candykingdom/hvac-v2/hardware/ref/hvac-v2_back.png

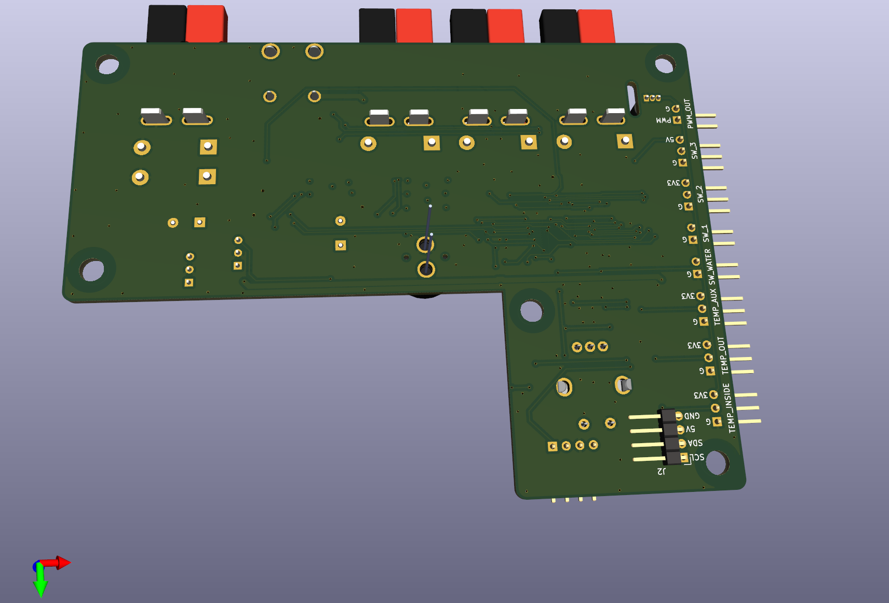
hardware/ref/hvac-v2_back.png
