candykingdom/hvac-v2/hardware/ref/hvac-v2_front.png

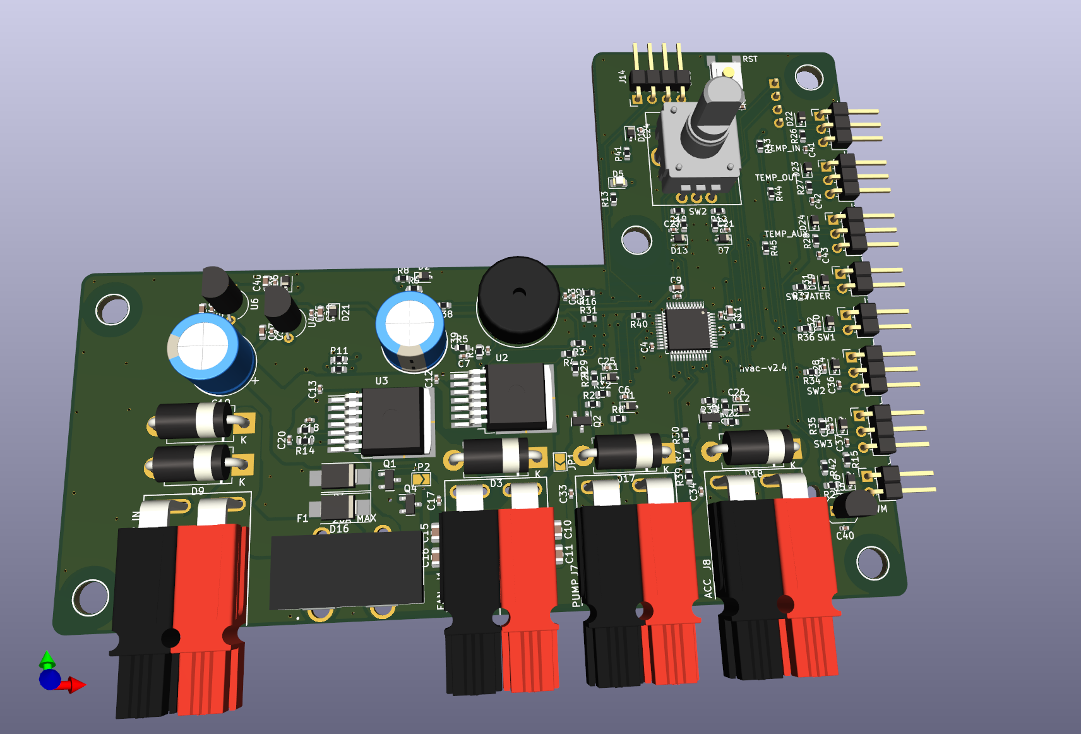
hardware/ref/hvac-v2_front.png
