candykingdom/hvac-v2/hardware/hvac-v2.kicad_pcb

## KiCad design hardware/hvac-v2.kicad_pcb (2022-07-19)

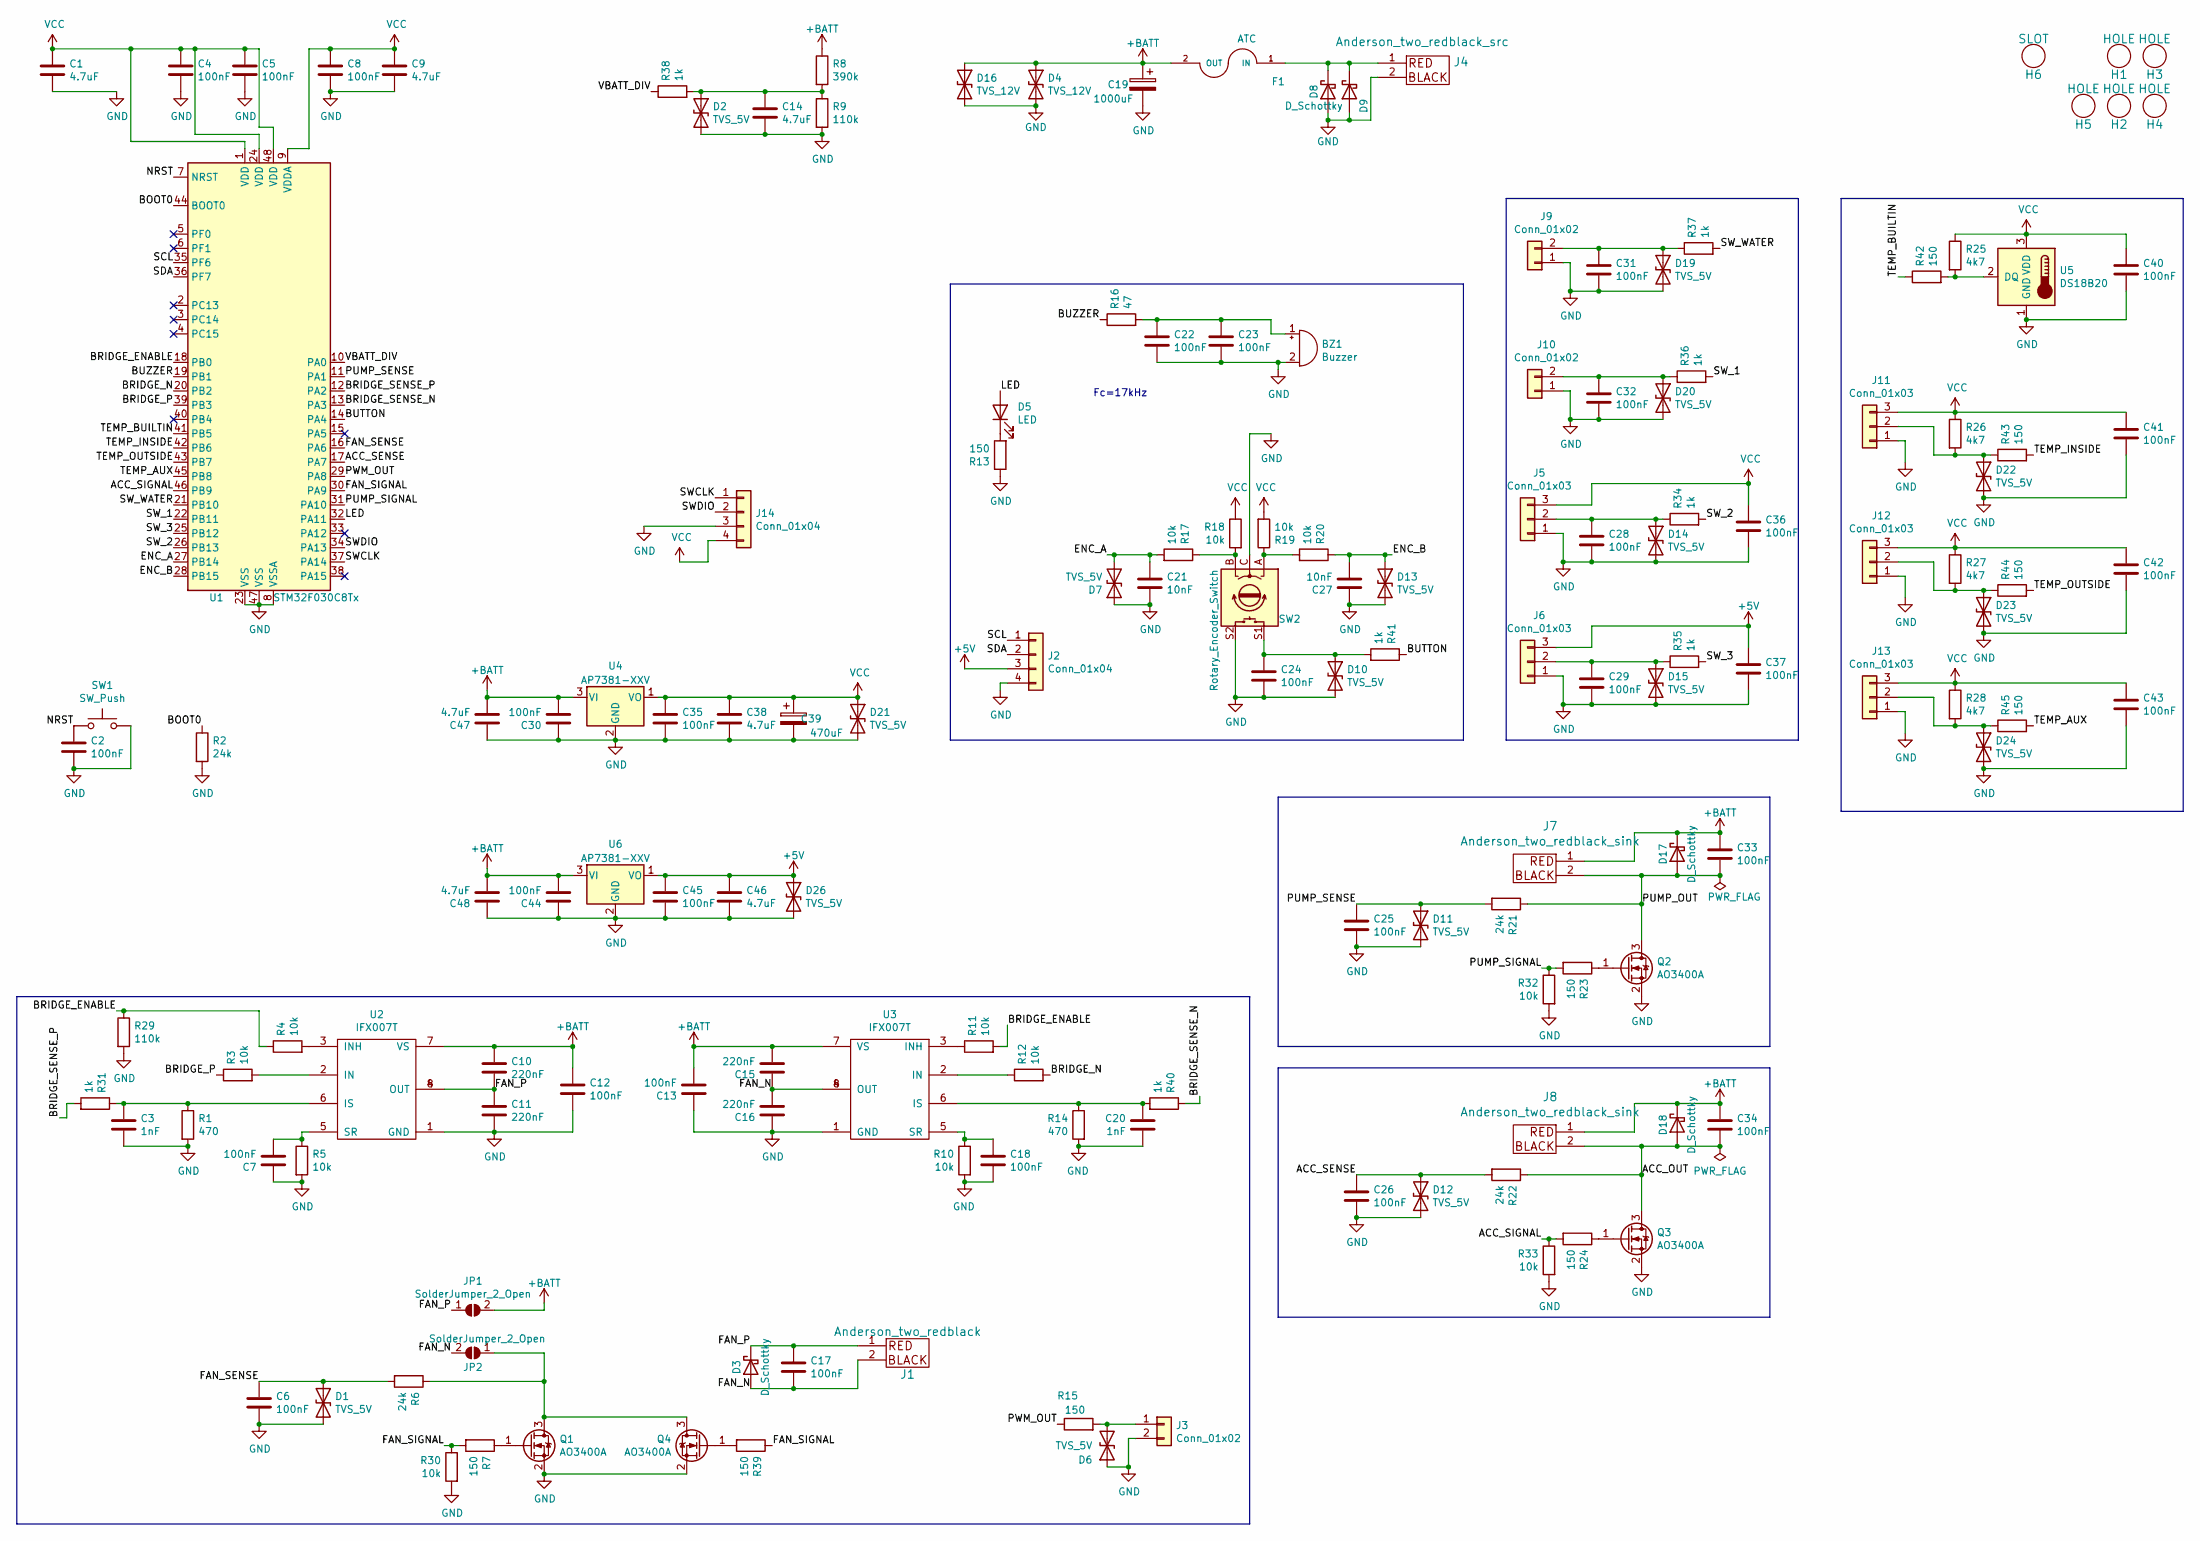
[picture p4: schematic hvac-v2.kicad_sch]

Parts:
BZ1: Buzzer; MURATA_PKM13EPYH4000-A0; MPN PKM13EPYH4000-A0
C1, C9, C14, C38, C46, C47, C48: 4.7uF; C_0603_1608Metric; LCSC C19666
C2, C4, C5, C6, C7, C8, C12, C13, C17, C18, C22, C23, C24, C25, C26, C28, C29, C30, C31, C32, C33, C34, C35, C36, C37, C40, C41, C42, C43, C44, C45: 100nF; C_0402_1005Metric; LCSC C307331
C3, C20: 1nF; C_0402_1005Metric; LCSC C1523
C10, C11, C15, C16: 220nF; C_0805_2012Metric; LCSC C5378
C19: 1000uF; CP_Radial_D10.0mm_P5.00mm; MPN 25PK1000MEFC10X16
C21, C27: 10nF; C_0402_1005Metric; LCSC C15195
C39: 470uF; CP_Radial_D10.0mm_P5.00mm; MPN 25PK1000MEFC10X16
D1, D2, D6, D7, D10, D11, D12, D13, D14, D15, D19, D20, D21, D22, D23, D24, D26: TVS_5V; D_SOD-323; LCSC C182013
D3, D8, D9, D17, D18: D_Schottky; D_DO-201AD_P12.70mm_Horizontal; MPN SB10150TA
D4, D16: TVS_12V; D_SMB_Handsoldering; MPN SMBJ16CA
D5: LED; LED_0805_2012Metric; LCSC C84256
F1: ATC; FUSE_3550-2; MPN 3550-2
H1, H2, H3, H4, H5: HOLE; HOLE_M4
H6: SLOT; SLOT_W2mm_H8mm
J1: Anderson_two_redblack; Anderson_1336G1_right_angle_bottom_two
J2, J14: Conn_01x04; PinHeader_1x04_P2.54mm_Horizontal
J3, J9, J10: Conn_01x02; PinHeader_1x02_P2.54mm_Horizontal
J4: Anderson_two_redblack_src; Anderson_1336G1_right_angle_bottom_two
J5, J6, J11, J12, J13: Conn_01x03; PinHeader_1x03_P2.54mm_Horizontal
J7, J8: Anderson_two_redblack_sink; Anderson_1336G1_right_angle_bottom_two
JP1, JP2: SolderJumper_2_Open; SolderJumper-2_P1.3mm_Open_TrianglePad1.0x1.5mm
Q1, Q2, Q3, Q4: AO3400A; SOT-23; LCSC C20917
R1, R14: 470; R_0603_1608Metric; LCSC C23179
R2, R6, R21, R22: 24k; R_0603_1608Metric; LCSC C23352
R3, R4, R5, R10, R11, R12, R17, R18, R19, R20, R30, R32, R33: 10k; R_0603_1608Metric; LCSC C25804
R7, R13, R15, R23, R24, R39, R42, R43, R44, R45: 150; R_0603_1608Metric; LCSC C22808
R8: 390k; R_0603_1608Metric; LCSC C23150
R9, R29: 110k; R_0603_1608Metric; LCSC C25805
R16: 47; R_0603_1608Metric; LCSC C23182
R25, R26, R27, R28: 4k7; R_0603_1608Metric; LCSC C23162
R31, R40, R41: 1k; R_0603_1608Metric; LCSC C11702
R34, R35, R36, R37, R38: 1k; R_0603_1608Metric; LCSC C22808
SW1: SW_Push; SW_TACTILE_5.1MM_TS-1187A-C-D-B; LCSC C318884
SW2: Rotary_Encoder_Switch; BOURNS_PEC12R-4xxxF-Sxxxx; MPN PEC12R-4230F-S0024
U1: STM32F030C8Tx; LQFP-48_7x7mm_P0.5mm; LCSC C23922
U2, U3: IFX007T; TO-263-7_TabPin8; MPN IFX007T
U4: AP7381-XXV; TO-92L_Inline_Wide; MPN AP7381-33V
U5: DS18B20; TO-92_Inline; MPN DS18B20
U6: AP7381-XXV; TO-92L_Inline_Wide; MPN AP7381-50V

Connections:
+5V: C37.1, C45.1, C46.1, D26.1 (A1), J2.3, J6.3, U6.1 (VO)
+BATT: C10.1, C12.1, C13.2, C15.2, C19.1, C30.2, C33.1, C34.1, C44.2, C47.2, C48.2, D4.1 (A1), D16.1 (A1), D17.1 (K), D18.1 (K), F1.2 (OUT), J7.1, J8.1, JP1.2 (B), R8.1, U2.7 (VS), U3.7 (VS), U4.3 (VI), U6.3 (VI)
/ACC_OUT: C34.2, D18.2 (A), J8.2, Q3.3 (D), R22.1
/ACC_SENSE: C26.1, D12.1 (A1), R22.2, U1.17 (PA7)
/ACC_SIGNAL: R24.2, R33.1, U1.46 (PB9)
/BOOT0: R2.1, U1.44 (BOOT0)
/BRIDGE_ENABLE: R4.1, R11.2, R29.1, U1.18 (PB0)
/BRIDGE_N: R12.2, U1.20 (PB2)
/BRIDGE_P: R3.1, U1.39 (PB3)
/BRIDGE_SENSE_N: R40.1, U1.13 (PA3)
/BRIDGE_SENSE_P: R31.2, U1.12 (PA2)
/BUTTON: R41.1, U1.14 (PA4)
/BUZZER: R16.1, U1.19 (PB1)
/ENC_A: C21.1, D7.2 (A2), R17.2, U1.27 (PB14)
/ENC_B: C27.2, D13.1 (A1), R20.1, U1.28 (PB15)
/FAN_N: C15.1, C16.2, C17.2, D3.2 (A), J1.2, JP2.2 (B), U3.4 (OUT), U3.8 (OUT)
/FAN_P: C10.2, C11.1, C17.1, D3.1 (K), J1.1, JP1.1 (A), U2.4 (OUT), U2.8 (OUT)
/FAN_SENSE: C6.1, D1.1 (A1), R6.2, U1.16 (PA6)
/FAN_SIGNAL: R7.2, R30.1, R39.1, U1.30 (PA9)
/LED: D5.2 (A), U1.32 (PA11)
/NRST: C2.1, SW1.1, U1.7 (NRST)
/PUMP_OUT: C33.2, D17.2 (A), J7.2, Q2.3 (D), R21.1
/PUMP_SENSE: C25.1, D11.1 (A1), R21.2, U1.11 (PA1)
/PUMP_SIGNAL: R23.2, R32.1, U1.31 (PA10)
/PWM_OUT: R15.1, U1.29 (PA8)
/SCL: J2.1, U1.35 (PF6)
/SDA: J2.2, U1.36 (PF7)
/SWCLK: J14.1, U1.37 (PA14)
/SWDIO: J14.2, U1.34 (PA13)
/SW_1: R36.2, U1.22 (PB11)
/SW_2: R34.2, U1.26 (PB13)
/SW_3: R35.2, U1.25 (PB12)
/SW_WATER: R37.2, U1.21 (PB10)
/TEMP_AUX: R45.2, U1.45 (PB8)
/TEMP_BUILTIN: R42.1, U1.41 (PB5)
/TEMP_INSIDE: R43.2, U1.42 (PB6)
/TEMP_OUTSIDE: R44.2, U1.43 (PB7)
/VBATT_DIV: R38.1, U1.10 (PA0)
GND: BZ1.2 (+), C1.2, C2.2, C3.2, C4.2, C5.2, C6.2, C7.1, C8.2, C9.2, C11.2, C12.2, C13.1, C14.2, C16.1, C18.2, C19.2, C20.2, C21.2, C22.2, C23.2, C24.2, C25.2, C26.2, C27.1, C28.2, C29.2, C30.1, C31.2, C32.2, C35.2, C36.2, C37.2, C38.2, C39.2, C40.2, C41.2, C42.2, C43.2, C44.1, C45.2, C46.2, C47.1, C48.1, D1.2 (A2), D2.2 (A2), D4.2 (A2), D6.1 (A1), D7.1 (A1), D8.2 (A), D9.2 (A), D10.2 (A2), D11.2 (A2), D12.2 (A2), D13.2 (A2), D14.2 (A2), D15.2 (A2), D16.2 (A2), D19.2 (A2), D20.2 (A2), D21.2 (A2), D22.2 (A2), D23.2 (A2), D24.2 (A2), D26.2 (A2), J2.4, J3.2, J4.2, J5.1, J6.1, J9.1, J10.1, J11.1, J12.1, J13.1, J14.3, Q1.2 (S), Q2.2 (S), Q3.2 (S), Q4.2 (S), R1.2, R2.2, R5.2, R9.2, R10.2, R13.1, R14.2, R29.2, R30.2, R32.2, R33.2, SW1.2, SW2.C, SW2.S2, U1.8 (VSSA), U1.23 (VSS), U1.47 (VSS), U2.1 (GND), U3.1 (GND), U4.2 (GND), U5.1 (GND), U6.2 (GND)
unnamed: BZ1.1 (-), C22.1, C23.1, R16.2
unnamed: C3.1, R1.1, R31.1, U2.6 (IS)
unnamed: C7.2, R5.1, U2.5 (SR)
unnamed: C14.1, D2.1 (A1), R8.2, R9.1, R38.2
unnamed: C18.1, R10.1, U3.5 (SR)
unnamed: C20.1, R14.1, R40.2, U3.6 (IS)
unnamed: C24.1, D10.1 (A1), R41.2, SW2.S1
unnamed: C28.1, D14.1 (A1), J5.2, R34.1
unnamed: C29.1, D15.1 (A1), J6.2, R35.1
unnamed: C31.1, D19.1 (A1), J9.2, R37.1
unnamed: C32.1, D20.1 (A1), J10.2, R36.1
unnamed: D5.1 (K), R13.2
unnamed: D6.2 (A2), J3.1, R15.2
unnamed: D8.1 (K), D9.1 (K), F1.1 (IN), J4.1
unnamed: D22.1 (A1), J11.2, R26.2, R43.1
unnamed: D23.1 (A1), J12.2, R27.2, R44.1
unnamed: D24.1 (A1), J13.2, R28.2, R45.1
unnamed: JP2.1 (A), Q1.3 (D), Q4.3 (D), R6.1
unnamed: Q1.1 (G), R7.1
unnamed: Q2.1 (G), R23.1
unnamed: Q3.1 (G), R24.1
unnamed: Q4.1 (G), R39.2
unnamed: R3.2, U2.2 (IN)
unnamed: R4.2, U2.3 (INH)
unnamed: R11.1, U3.3 (INH)
unnamed: R12.1, U3.2 (IN)
unnamed: R17.1, R18.2, SW2.B
unnamed: R19.1, R20.2, SW2.A
unnamed: R25.2, R42.2, U5.2 (DQ)
VCC: C1.1, C4.1, C5.1, C8.1, C9.1, C35.1, C36.1, C38.1, C39.1, C40.1, C41.1, C42.1, C43.1, D21.1 (A1), J5.3, J11.3, J12.3, J13.3, J14.4, R18.1, R19.2, R25.1, R26.1, R27.1, R28.1, U1.1 (VDD), U1.9 (VDDA), U1.24 (VDD), U1.48 (VDD), U4.1 (VO), U5.3 (VDD)

Notes on the sheet:
Fc=17kHz

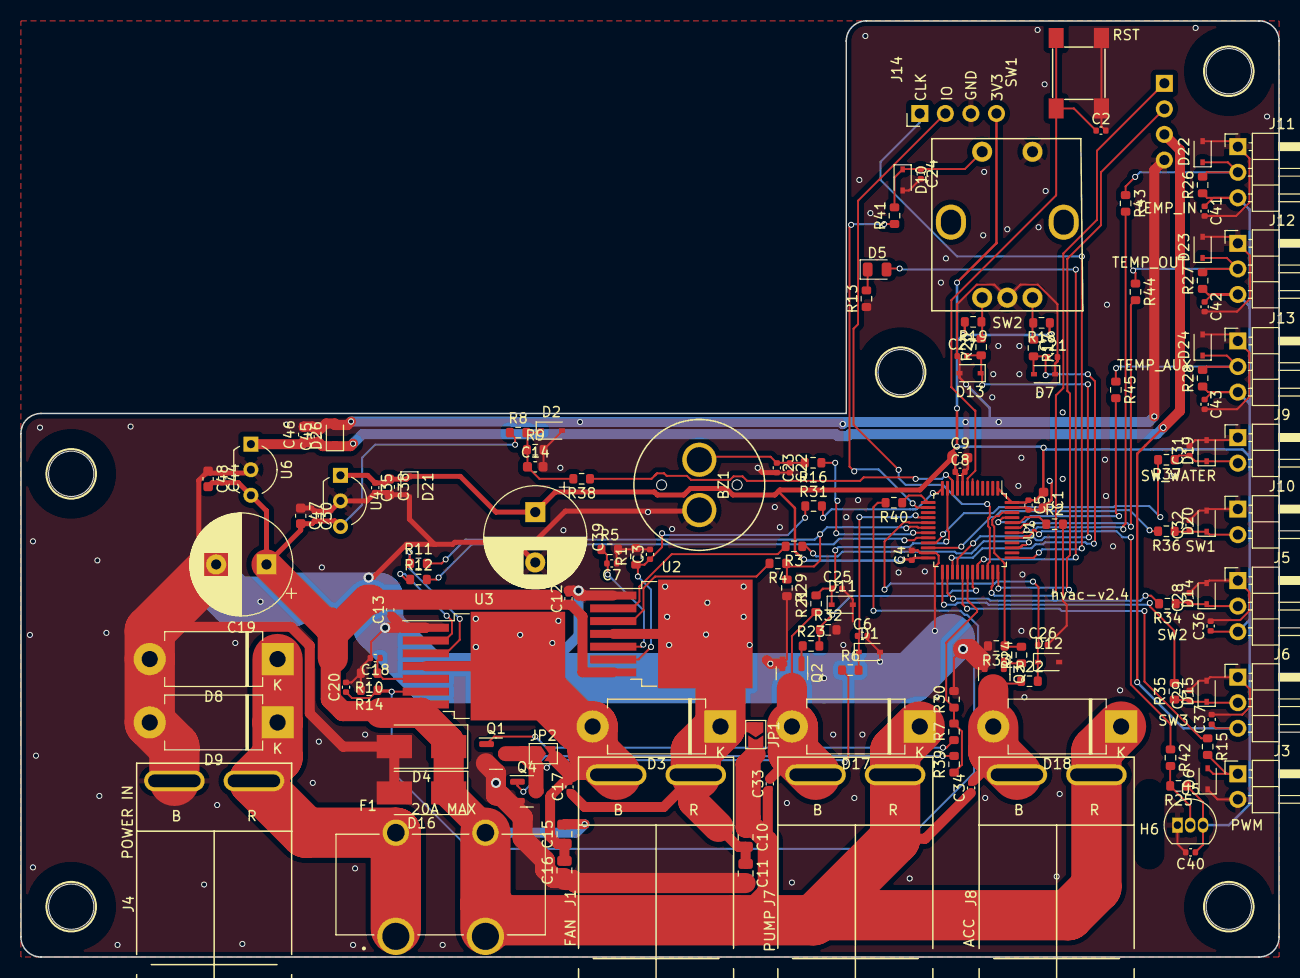
[picture p5: board hvac-v2.kicad_pcb from above]

Board: 2 copper layers, 125.0 x 93.0 mm, 154 parts (1 on the bottom side), 69 nets.
