candykingdom/hvac-v2/hardware/assemblysheet.png

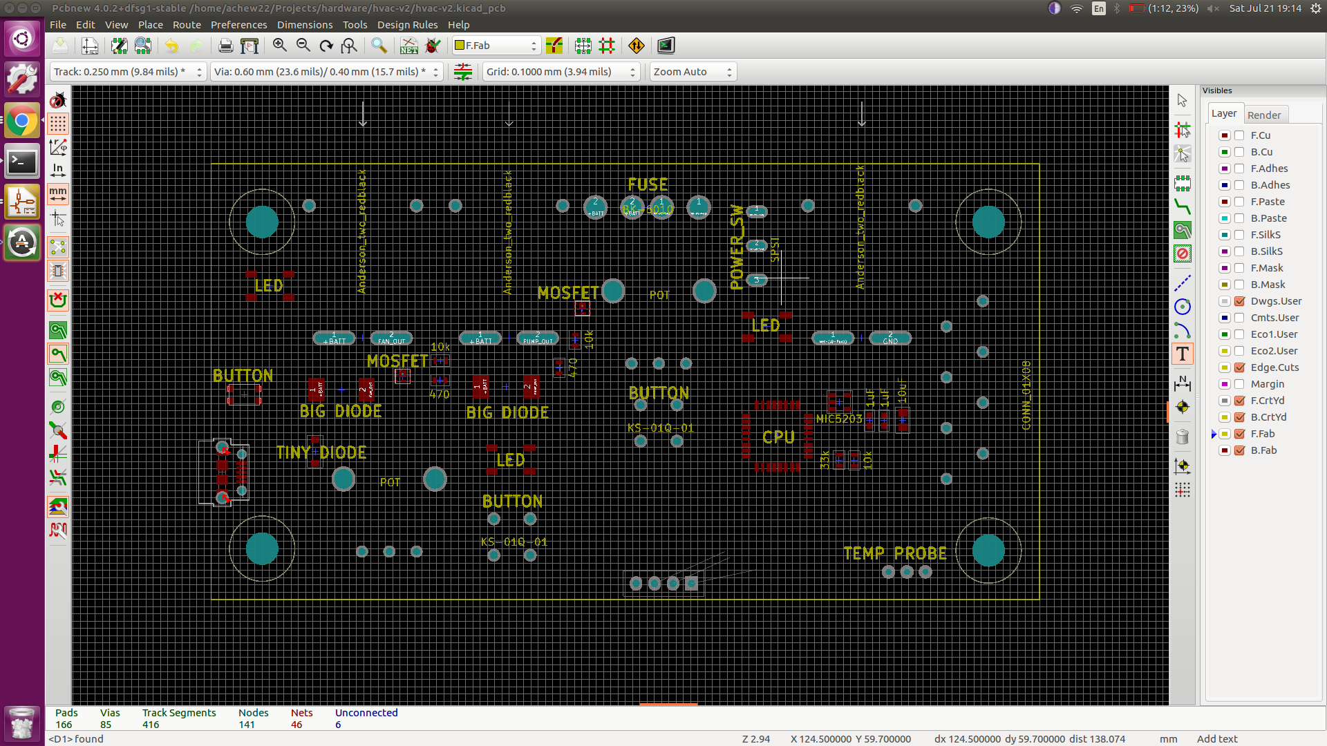
hardware/assemblysheet.png
