candykingdom/hvac-v2/(commit log)

2018-07-20 Initial commit - first pass at v2.0 schematic
    [battery-protector-v2.kicad_pcb, battery-protector-v2.sch]
2018-07-20 Added footprints
    [battery-protector-v2.sch]
2018-07-21 Rename to hvac
    [hvac-v2.kicad_pcb, hvac-v2.sch]
2018-07-21 Switch to a potentiometer for mode control
    [hvac-v2.sch]
2018-07-21 Associate footprints
    [hvac-v2.sch]
2018-07-21 First pass rough placement
    [hvac-v2.kicad_pcb]
2018-07-21 Route power (GIANT TRACES)
    [hvac-v2.kicad_pcb, hvac-v2.sch]
2018-07-21 First pass routing. Still has DRC errors
    [hvac-v2.kicad_pcb]
2018-07-21 DRC fixes
    [hvac-v2.kicad_pcb]
2018-07-21 More DRC fixes
    [hvac-v2.kicad_pcb]
2018-07-21 Move cut line up by a mm
    [hvac-v2.kicad_pcb]
2018-07-21 Add silkscreen version and test/cal
    [hvac-v2.kicad_pcb]
2018-07-22 Place the programming header and diode
    [hvac-v2.kicad_pcb, hvac-v2.sch]
2018-07-22 More silkscreens + generate assembly sheet
    [hvac-v2.kicad_pcb]
2018-07-22 Connect programming headers
    [hvac-v2.kicad_pcb]
2018-08-01 Hardware revision 2.1: - Fix SWD connection to power to not connect directly to VCC - Add silk labels for controls
    [hvac-v2-B.Adhes.gbr, hvac-v2-B.CrtYd.gbr, hvac-v2-B.Cu.gbr, hvac-v2-B.Fab.gbr, hvac-v2-B.Mask.gbr, hvac-v2-B.Paste.gbr, hvac-v2-B.SilkS.gbr, hvac-v2-Edge.Cuts.gbr]
2018-08-19 Fix temp loop to actually request temperature
    [hvac_v2_test.ino]
2018-08-19 Add power led
2018-08-19 Only request temp in temp loop - fixes broken fan speed button
    [hvac_v2_test.ino]
2018-08-19 make fan speed LED pulse brighter
2022-04-19 Start updating schematic for JLC assembly
    [hvac-v2-2019-10-05-20-15-38.sch]
2022-04-20 Start adding motor drivers
    [hvac-v2.sch]
2022-04-22 Finish updating schematic for JLC assembly
    [hvac-v2.sch]
2022-04-22 Start placing components
    [hvac-v2.kicad_pcb, hvac-v2.sch]
2022-04-23 Component placement finished
    [hvac-v2.kicad_pcb, hvac-v2.sch]
2022-04-23 Start routing
    [hvac-v2.kicad_pcb, hvac-v2.sch]
2022-04-23 Update to KiCAD v6 format
    [hvac-v2.kicad_pcb, hvac-v2.kicad_sch]
2022-04-23 First pass at routing
    [hvac-v2.kicad_pcb, hvac-v2.kicad_sch]
2022-04-24 Hardware revision v2.2.
    Complete redesign. Has an I2C port for a screen and a rotary encoder
    with a button. Is designed for SMT assembly using JLCPCB.
    [hvac-v2-B.Adhes.gbr, hvac-v2-B.CrtYd.gbr, hvac-v2-B.Cu.gbr, hvac-v2-B.Fab.gbr, hvac-v2-B.Mask.gbr, hvac-v2-B.Paste.gbr, hvac-v2-B.SilkS.gbr, hvac-v2-B_Cu.gbl]
2022-05-04 Move PCB to subdir
    [hvac-v2-2019-10-05-20-15-38.sch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]
2022-05-04 Add basic Arduino Menu usage
2022-05-13 Untrack build and KiCAD backup dirs
2022-05-13 Read temp sensors on Arduino
2022-05-18 Start hardware revision 2.3: fix LCD I2C
    [hvac-v2.kicad_pcb, hvac-v2.kicad_sch]
2022-05-18 Add buzzer pin
2022-05-20 Complete hardware v2.3:
    - Fix LCD I2C pins
    - Switch to voltage regulators with higher input voltage range
    - Increase 12v line TVS diodes
    [hvac-v2-B_Cu.gbl, hvac-v2-B_Mask.gbs, hvac-v2-B_Paste.gbp, hvac-v2-B_Silkscreen.gbo, hvac-v2-Edge_Cuts.gm1, hvac-v2-F_Courtyard.gbr, hvac-v2-F_Cu.gtl, hvac-v2-F_Mask.gts]
2022-06-02 Add fan and pump pins
2022-07-08 Start adding handling for invalid temperatures
2022-07-08 Display pump and fan status
2022-07-08 Display current sense
2022-07-08 Fix deps
    Update ClickEncoder to use HTTPS, not SSH, and pin versions.
2022-07-09 Add support for all fan output types
2022-07-09 Add test framework
2022-07-10 Add battery voltage to inputs
2022-07-10 Fix battery voltage
2022-07-10 Add config for fan direction, and seperate speeds for vent and swamp
2022-07-10 Add ramp for fan PWM
2022-07-11 Add duty cycle for pump
2022-07-13 Start updating schematic for v2.4
    [hvac-v2.kicad_sch]
2022-07-14 Cleanup pump duty cycle
2022-07-19 Hardware revision 2.4:
    - Actually wire encoder button to processor
    - Increase power trace widths
    - Fix encoder RC circuit cap size
    - Add silk labels on top
    - Add protection resistors to all IO
    [hvac-v2-B_Cu.gbl, hvac-v2-B_Mask.gbs, hvac-v2-B_Paste.gbp, hvac-v2-B_Silkscreen.gbo, hvac-v2-Edge_Cuts.gm1, hvac-v2-F_Courtyard.gbr, hvac-v2-F_Cu.gtl, hvac-v2-F_Mask.gts]
2022-08-03 Add 3d model for pcb
2023-02-09 Actually check if temp sensors are connected
2023-06-08 Add MOSFET_BANGBANG mode
